antonio-mariano/sleep-monitor/(commit log)

2026-02-04 Add schematic image and defined R0 resistance
2026-02-04 Initialize README with project details and instructions
    Added detailed project overview, components, circuit building instructions, and analysis tools for the Sleep Monitor project.
2026-02-04 Initialize README with project details and setup instructions
    Added detailed project description, components, circuit building instructions, and analysis tools for the Sleep Monitor project.
2026-02-06 Revise README for clarity on sensors and circuit
    Updated sections on pressure sensors and circuit building in README.md.
2026-02-06 Refine README for clarity and formatting, started Data transfer and analisys
    Corrected formatting inconsistencies and improved clarity in the README content. Updated sections on Wi-Fi setup, sensor calibration, and analysis tools.
2026-02-06 Update analysis scripts, firmware fixes, and add new images
    [Communication.cpp, Communication.h, WifiControl.cpp, WifiControl.h, sensors.cpp, sleep-monitor.ino]
2026-02-07 Revise README with new images and sensor details
    Updated images and descriptions in the README for clarity and added new sensor assembly details.
